MatthiasPopp/replicape/PCB_rev_B4/Replicape_B4.brd

## EAGLE design PCB_rev_B4/Replicape_B4.brd (2019-10-06)

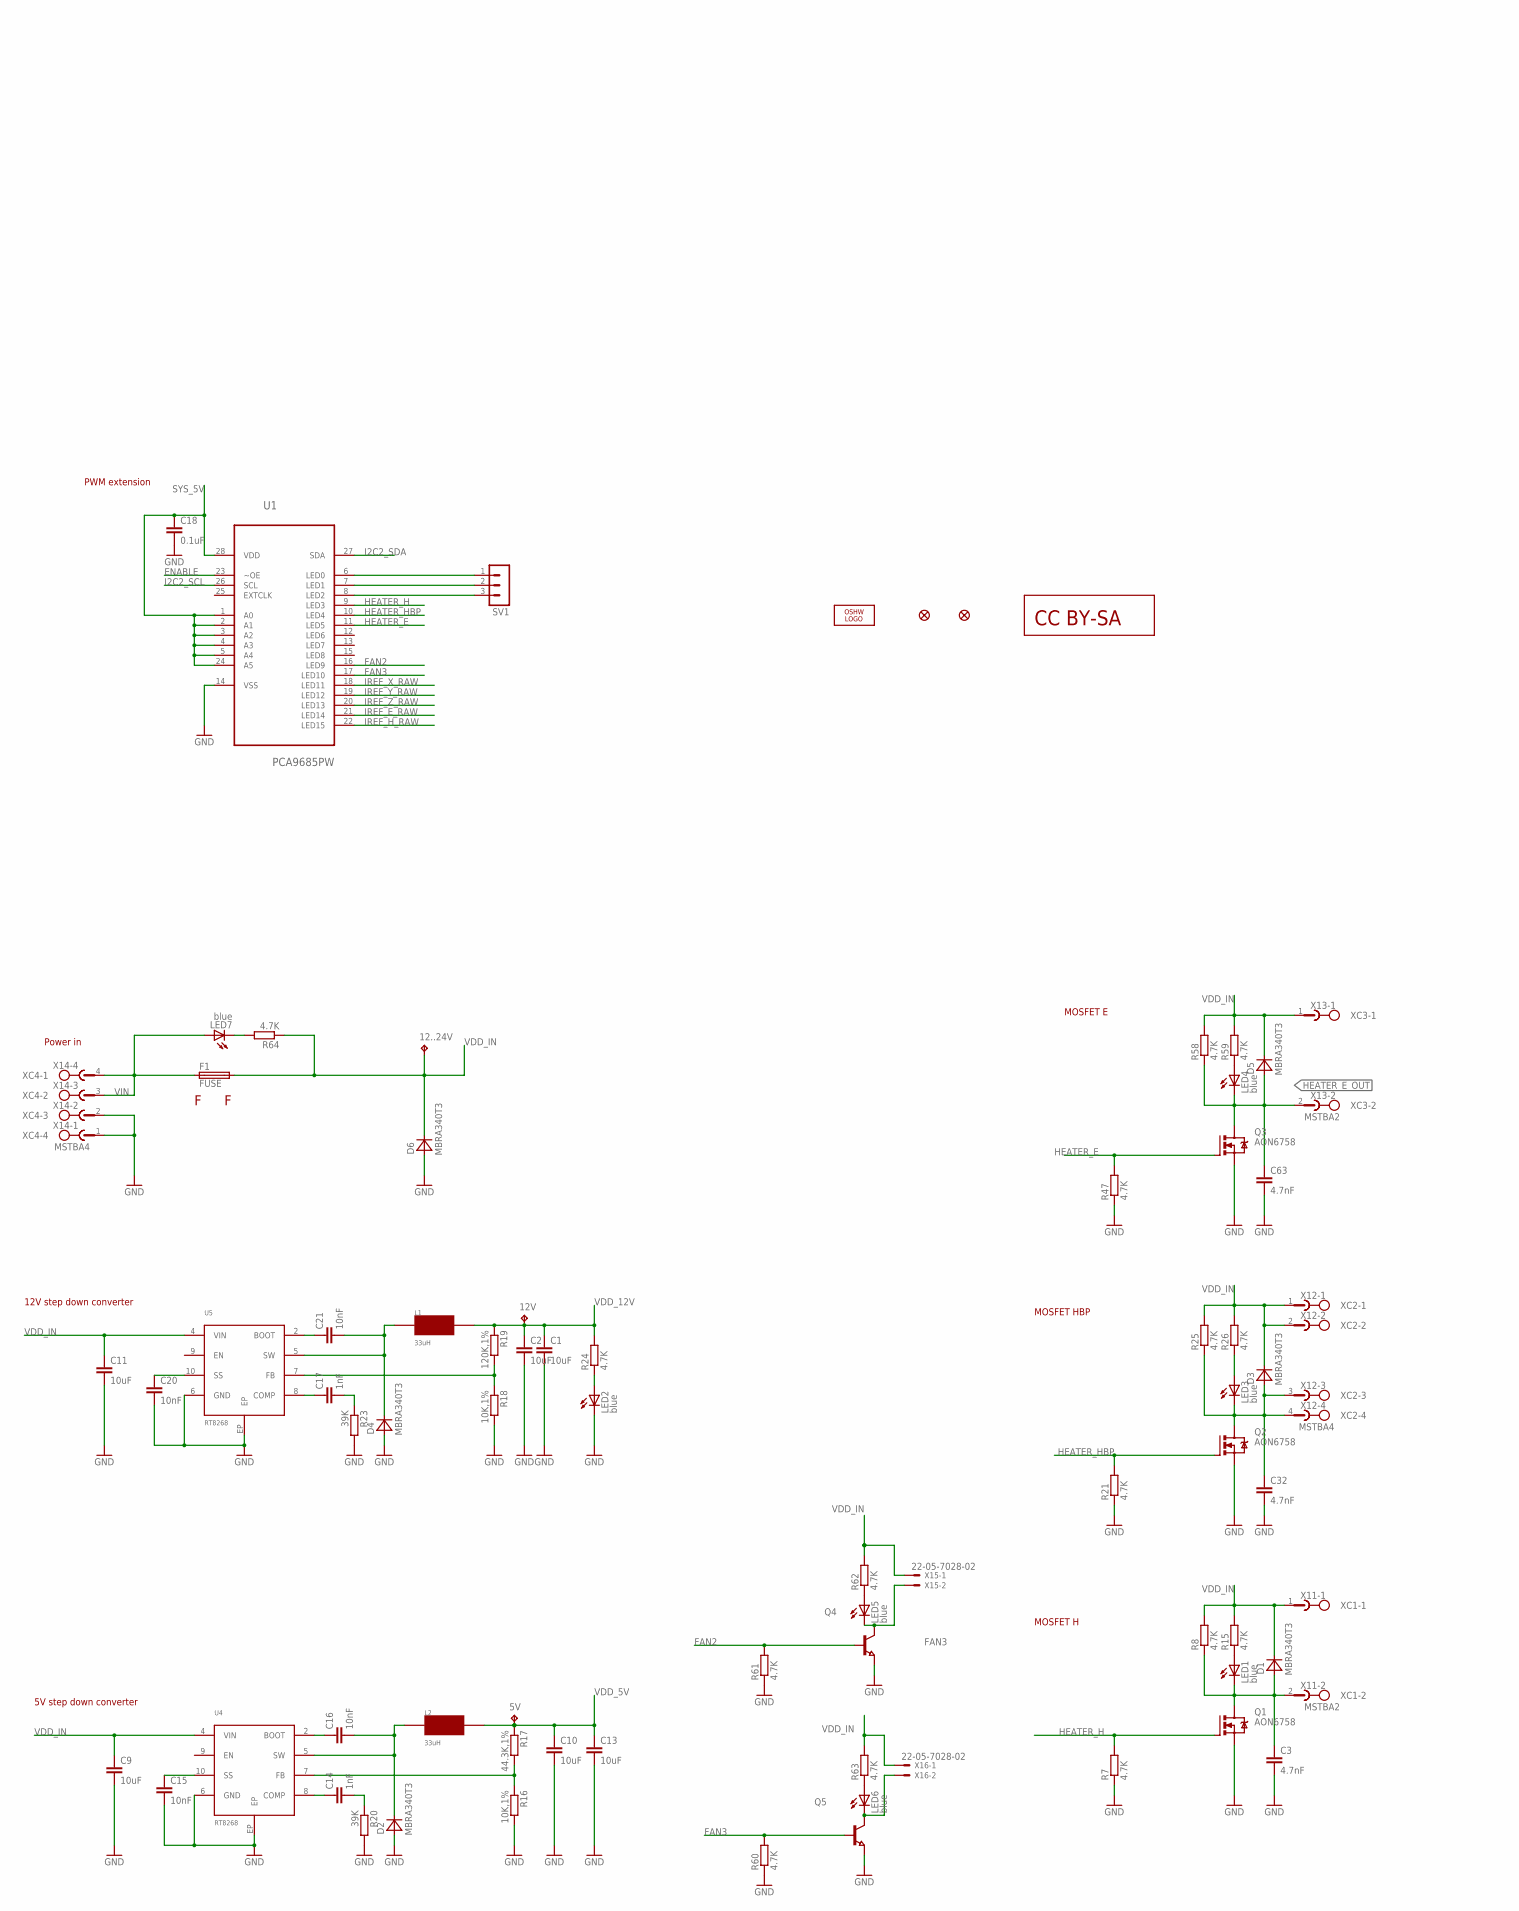
[picture p1: schematic Replicape_B4.sch, sheet 1, part in row 1, column 1]

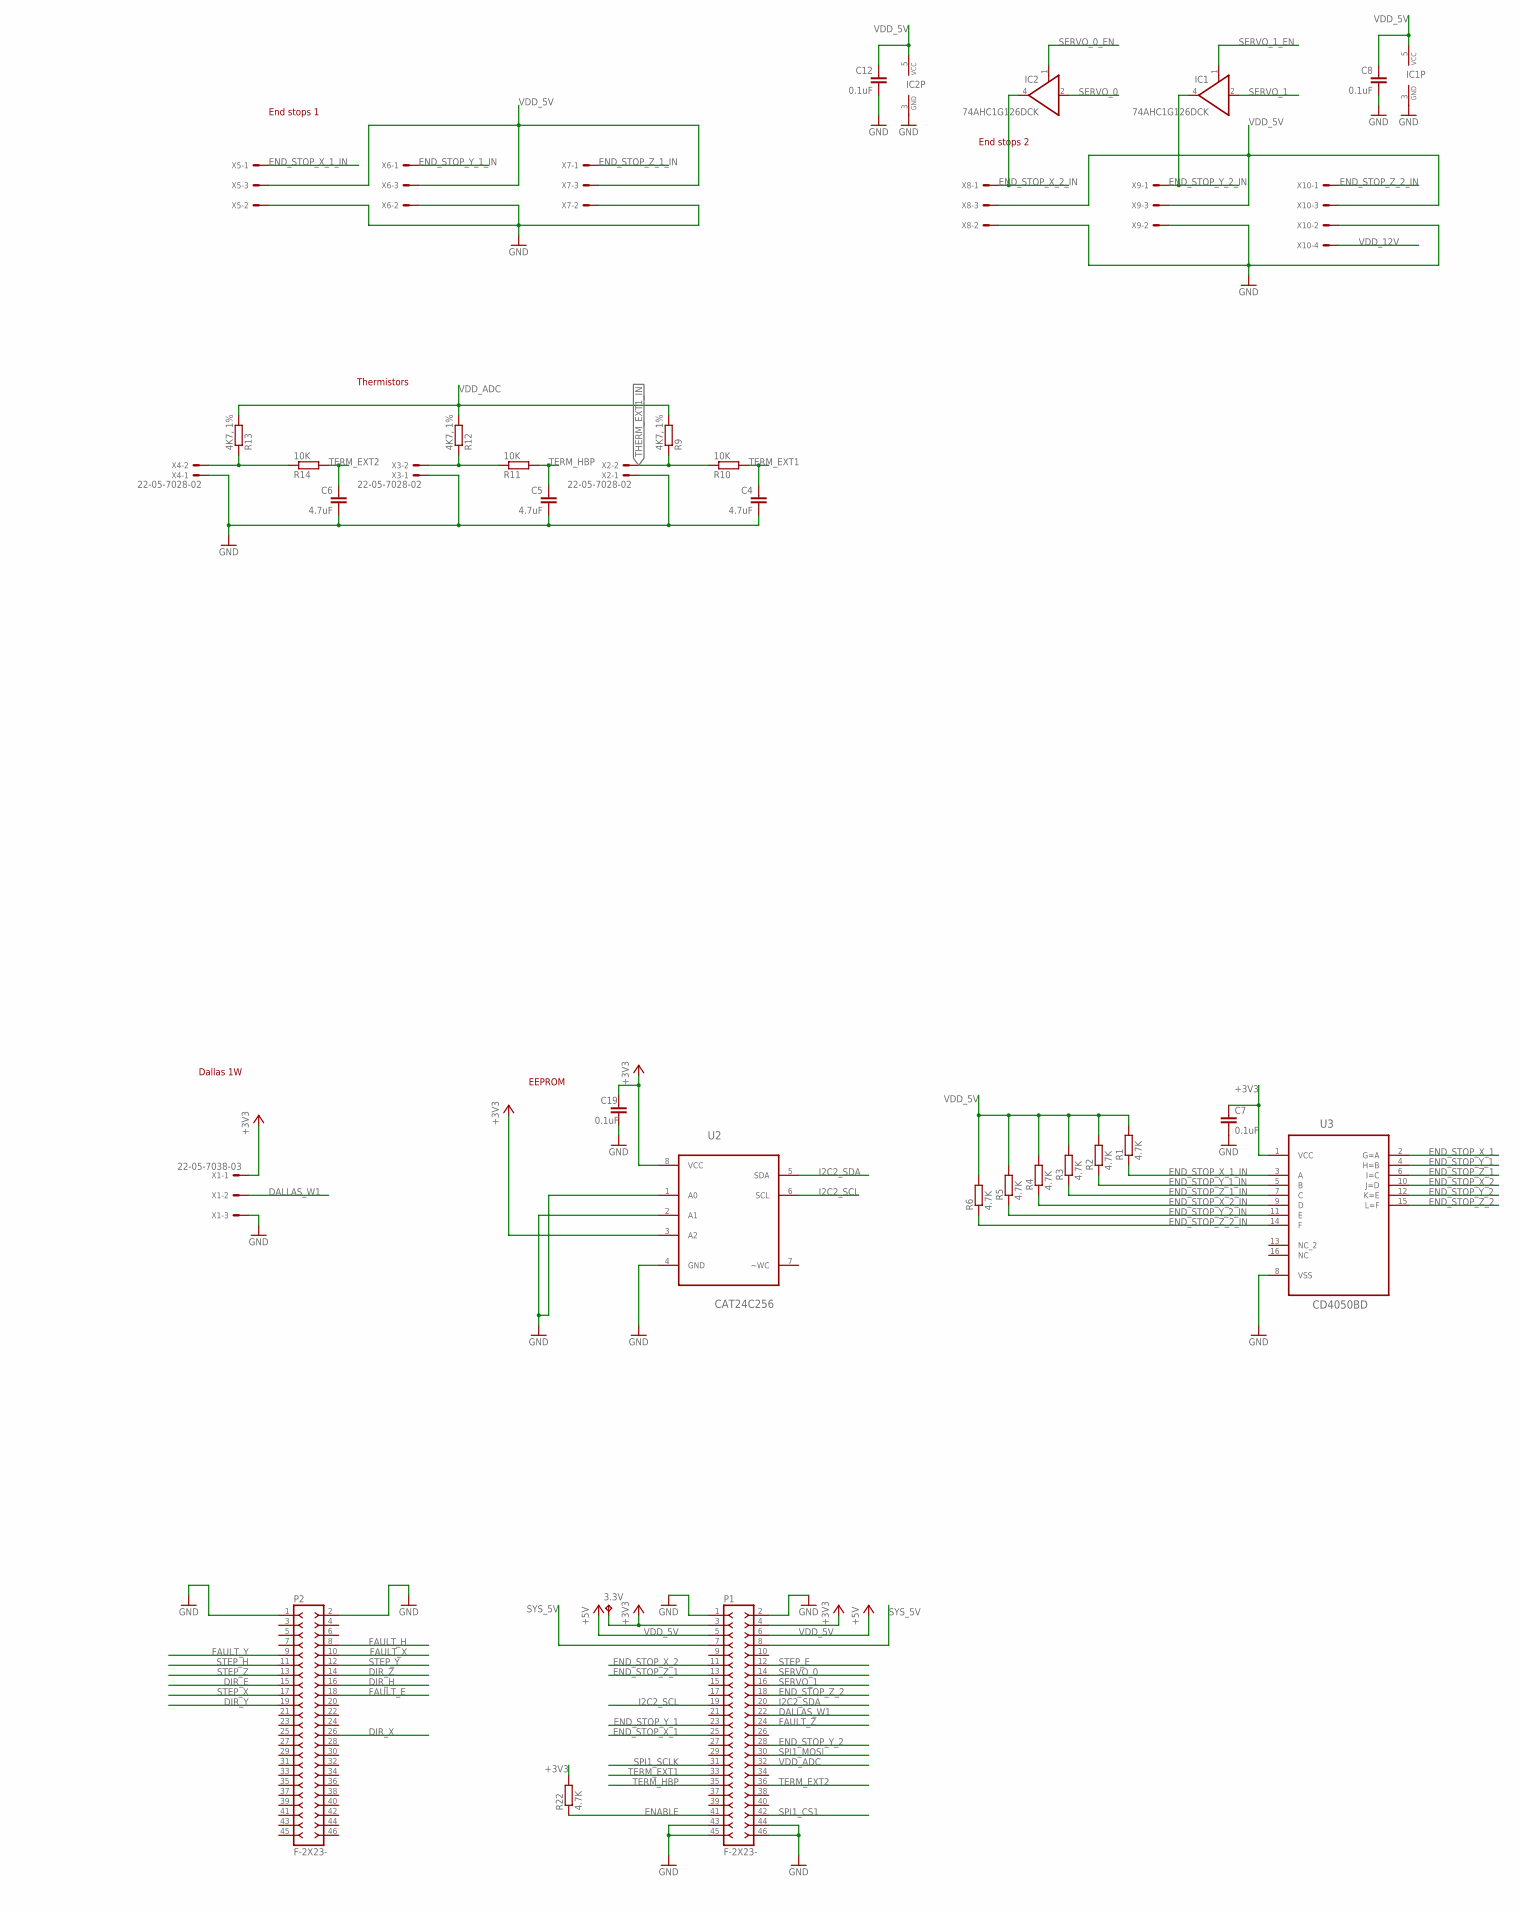
[picture p2: schematic Replicape_B4.sch, sheet 1, part in row 1, column 2]

Parts:
3.3V, 5V, 12..24V, 12V: TPB1,27; B1,27
C1, C2, C9, C10, C11, C13: 10uF; C1206; MPN CL31B106KAHNNNE
C3, C32, C63: 4.7nF; C0402; MPN CL05B472KA5NNNC
C4, C5, C6: 4.7uF; C0402; MPN GRM155R60J475ME47D
C7, C8, C12, C18, C19: 0.1uF; C0402; MPN CL10B104KB8NNND
C14, C17: 1nF; C0402; MPN C1005X7R1H102K050BA
C15, C16, C20, C21: 10nF; C0402; MPN CL05B103KB5NNNC
D1, D2, D3, D4, D5, D6: MBRA340T3; SMA; MPN MBRA340T3G
F1: FUSE; 3557; MPN 0891020.NXS
FH1, FH2: FUSE-HOLDER; MPN 3557
IC1, IC2: 74AHC1G126DCK; SC70-5; MPN M74VHC1GT126DF1G
JP1, JP2: FIDUCIAL1X2.5; FIDUCIAL-1X2.5
L1, L2: 33uH; NR8040T330; MPN NR8040T330M
LED1, LED2, LED3, LED4, LED5, LED6, LED7: blue; CHIP-LED0603; MPN Q65110A7211
LOGO1: OSHW_LOGO_FILLX0200-NT; OSHW_FILLX200_NOTEXT
P1, P2: F-2X23-; DIL-100-2X23; MPN SSHQ-123-D-08-F-LF
Q1, Q2, Q3: AON6758; 8-DFN-EP-(5X6); MPN SIRA34DP-T1-GE3
Q4, Q5: NPN-TRANSISTOR_SOT23; SOT23; MPN AO7400
R1, R2, R3, R4, R5, R6, R7, R8, R15, R21, R22, R24, R25, R26, R47, R58, R59, R60, R61, R62, R63, R64: 4.7K; R0402; MPN RC0402JR-074K7L
R9, R12, R13: 4K7, 1%; R0402; MPN RC0402FR-074K7L
R10, R11, R14: 10K; R0402; MPN RC0402FR-0710KL
R16, R18: 10K,1%; R0402; MPN RC0402FR-0710KL
R17: 44.3K,1%; R0402; MPN RC1005F4422CS
R19: 120K,1%; R0402; MPN RMCF0402FT120K
R20, R23: 39K; R0402; MPN RC1005J393CS
SV1: MA03-1
U1: PCA9685PW; SOP65P640X110-28N; MPN PCA9685PW,112
U2: CAT24C256; SOIC127P600X175-8N; MPN CAT24C256WI-GT3
U3: CD4050BD; SOIC127P600X175-16N; MPN CD4050BDR
U4, U5: RT8268; MSOP10; MPN RT8268GFP
U$1: CC-BY-SA
X1, X5, X6, X7, X8, X9: 22-05-7038-03; 7395-03; MPN 640455-3
X2, X3, X4, X15, X16: 22-05-7028-02; 7395-02; MPN 640455-2
X10: 22-05-7048-04; 7395-04; MPN 640455-4
X11, X13: MSTBA2; MPN 39532-1002
X12, X14: MSTBA4; MPN 39532-1004
XC1, XC3: MSTBV2-CONNECTOR; MSTBA2-CONNECTOR; MPN 39530-0002
XC2, XC4: MSTBA4-CONNECTOR; MPN 39530-0004

Connections:
+3V3: 3.3V.TP, C7.1, C19.1, P1.3, P1.4, R22.2, U2.3 (A2), U2.8 (VCC), U3.1 (VCC), X1.1; also elsewhere on the board
DALLAS_W1: P1.22, X1.2
DIR_E: P2.15; also elsewhere on the board
DIR_H: P2.16; also elsewhere on the board
DIR_X: P2.26; also elsewhere on the board
DIR_Y: P2.19; also elsewhere on the board
DIR_Z: P2.14; also elsewhere on the board
ENABLE: P1.41, R22.1, U1.23 (~OE)
END_STOP_X_1: P1.25, U3.2 (G=A)
END_STOP_X_1_IN: R1.1, U3.3 (A), X5.1
END_STOP_X_2: P1.11, U3.10 (J=D)
END_STOP_X_2_IN: IC2.4 (O), R4.1, U3.9 (D), X8.1
END_STOP_Y_1: P1.23, U3.4 (H=B)
END_STOP_Y_1_IN: R2.1, U3.5 (B), X6.1
END_STOP_Y_2: P1.28, U3.12 (K=E)
END_STOP_Y_2_IN: IC1.4 (O), R5.1, U3.11 (E), X9.1
END_STOP_Z_1: P1.13, U3.6 (I=C)
END_STOP_Z_1_IN: R3.1, U3.7 (C), X7.1
END_STOP_Z_2: P1.18, U3.15 (L=F)
END_STOP_Z_2_IN: R6.1, U3.14 (F), X10.1
FAN2: Q4.1 (B), R61.2, U1.16 (LED9)
FAN3: Q5.1 (B), R60.2, U1.17 (LED10)
FAULT_E: P2.18; also elsewhere on the board
FAULT_H: P2.8; also elsewhere on the board
FAULT_X: P2.10; also elsewhere on the board
FAULT_Y: P2.9; also elsewhere on the board
FAULT_Z: P1.24; also elsewhere on the board
GND: C1.2, C2.2, C3.2, C4.2, C5.2, C6.2, C7.2, C8.2, C9.2, C10.2, C11.2, C12.2, C13.2, C15.2, C18.2, C19.2, C20.2, C32.2, C63.2, D2.A, D4.A, D6.A, IC1.3 (GND), IC2.3 (GND), LED2.C, P1.1, P1.2, P1.43, P1.44, P1.45, P1.46, P2.1, P2.2, Q1.1 (S), Q1.2 (S), Q1.3 (S), Q2.1 (S), Q2.2 (S), Q2.3 (S), Q3.1 (S), Q3.2 (S), Q3.3 (S), Q4.2 (E), Q5.2 (E), R7.1, R16.2, R18.2, R20.2, R21.1, R23.2, R47.1, R60.1, R61.1, U1.14 (VSS), U2.1 (A0), U2.2 (A1), U2.4 (GND), U3.8 (VSS), U4.6 (GND), U4.EP, U5.6 (GND), U5.EP, X1.3, X2.1, X3.1, X4.1, X5.2, X6.2, X7.2, X8.2, X9.2, X10.2, X14.1, X14.2; also elsewhere on the board
HEATER_E: Q3.4 (G), R47.2, U1.11 (LED5)
HEATER_E_OUT: C63.1, D5.A, LED4.C, Q3.5 (D), Q3.6 (D), Q3.7 (D), Q3.8 (D), Q3.TH (D), R58.1, X13.2
HEATER_H: Q1.4 (G), R7.2, U1.9 (LED3)
HEATER_HBP: Q2.4 (G), R21.2, U1.10 (LED4)
I2C2_SCL: P1.19, U1.26 (SCL), U2.6 (SCL)
I2C2_SDA: P1.20, U1.27 (SDA), U2.5 (SDA)
IREF_E_RAW: U1.21 (LED14); also elsewhere on the board
IREF_H_RAW: U1.22 (LED15); also elsewhere on the board
IREF_X_RAW: U1.18 (LED11); also elsewhere on the board
IREF_Y_RAW: U1.19 (LED12); also elsewhere on the board
IREF_Z_RAW: U1.20 (LED13); also elsewhere on the board
unnamed: SV1.1, U1.6 (LED0)
unnamed: LED7.C, R64.2
unnamed: R16.1, R17.2, U4.7 (FB)
unnamed: C16.2, D2.C, L2.P$2, U4.5 (SW)
unnamed: C15.1, U4.10 (SS)
unnamed: C3.1, D1.A, LED1.C, Q1.5 (D), Q1.6 (D), Q1.7 (D), Q1.8 (D), Q1.TH (D), R8.1, X11.2
unnamed: C16.1, U4.2 (BOOT)
unnamed: C14.1, U4.8 (COMP)
unnamed: LED2.A, R24.1
unnamed: C14.2, R20.1
unnamed: LED6.C, Q5.3 (C), X16.2
unnamed: LED5.C, Q4.3 (C), X15.2
unnamed: LED5.A, R62.1
unnamed: LED6.A, R63.1
unnamed: SV1.3, U1.8 (LED2)
unnamed: SV1.2, U1.7 (LED1)
unnamed: LED4.A, R59.1
unnamed: LED1.A, R15.1
unnamed: LED3.A, R26.1
unnamed: R18.1, R19.2, U5.7 (FB)
unnamed: C21.2, D4.C, L1.P$2, U5.5 (SW)
unnamed: R13.1, R14.1, X4.2
unnamed: R11.1, R12.1, X3.2
unnamed: C32.1, D3.A, LED3.C, Q2.5 (D), Q2.6 (D), Q2.7 (D), Q2.8 (D), Q2.TH (D), R25.1, X12.3, X12.4
unnamed: C20.1, U5.10 (SS)
unnamed: C17.1, U5.8 (COMP)
unnamed: C21.1, U5.2 (BOOT)
unnamed: C17.2, R23.1
SERVO_0: IC2.2 (I), P1.14
SERVO_0_EN: IC2.1 (OE); also elsewhere on the board
SERVO_1: IC1.2 (I), P1.16
SERVO_1_EN: IC1.1 (OE); also elsewhere on the board
SPI1_CS1: P1.42; also elsewhere on the board
SPI1_MOSI: P1.30; also elsewhere on the board
SPI1_SCLK: P1.31; also elsewhere on the board
STEP_E: P1.12; also elsewhere on the board
STEP_H: P2.11; also elsewhere on the board
STEP_X: P2.17; also elsewhere on the board
STEP_Y: P2.12; also elsewhere on the board
STEP_Z: P2.13; also elsewhere on the board
SYS_5V: C18.1, P1.7, P1.8, U1.1 (A0), U1.2 (A1), U1.3 (A2), U1.4 (A3), U1.5 (A4), U1.24 (A5), U1.28 (VDD)
TERM_EXT1: C4.1, P1.33, R10.2
TERM_EXT2: C6.1, P1.36, R14.2
TERM_HBP: C5.1, P1.35, R11.2
THERM_EXT1_IN: R9.1, R10.1, X2.2
VDD_5V: 5V.TP, C8.1, C10.1, C12.1, C13.1, IC1.5 (VCC), IC2.5 (VCC), L2.P$1, P1.5, P1.6, R1.2, R2.2, R3.2, R4.2, R5.2, R6.2, R17.1, X5.3, X6.3, X7.3, X8.3, X9.3, X10.3
VDD_12V: 12V.TP, C1.1, C2.1, L1.P$1, R19.1, R24.2, X10.4
VDD_ADC: P1.32, R9.2, R12.2, R13.2
VDD_IN: 12..24V.TP, C9.1, C11.1, D1.C, D3.C, D5.C, D6.C, F1.P$3 (2), F1.P$4 (2), R8.2, R15.2, R25.2, R26.2, R58.2, R59.2, R62.2, R63.2, R64.1, U4.4 (VIN), U5.4 (VIN), X11.1, X12.1, X12.2, X13.1, X15.1, X16.1; also elsewhere on the board
VIN: F1.P$1 (1), F1.P$2 (1), LED7.A, X14.3, X14.4

Notes on the sheet:
PWM extension
Power in
5V step down converter
12V step down converter
MOSFET E
MOSFET HBP
MOSFET H
End stops 2
Thermistors
End stops 1
EEPROM
Dallas 1W

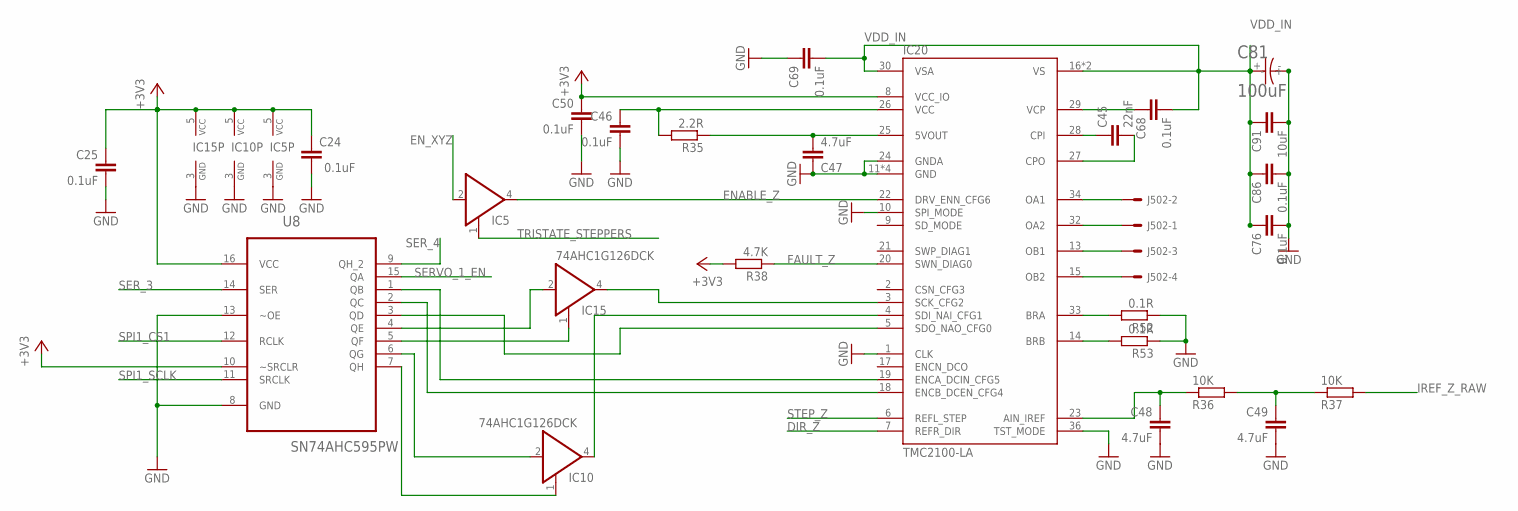
[picture p3: schematic Replicape_B4.sch, sheet 2]

Parts:
C24, C25, C46, C50, C68, C69, C76, C86: 0.1uF; C0402; MPN CL10B104KB8NNND
C45: 22nF; C0402; MPN C1005X7R1E223K050BB
C47, C48, C49: 4.7uF; C0402; MPN GRM155R60J475ME47D
C81: 100uF; RHS1V10MCN1GS; MPN RHS1V101MCN1GS
C91: 10uF; C0805; MPN C2012X5R1V106M085AC
IC5, IC10, IC15: 74AHC1G126DCK; SC70-5; MPN M74VHC1GT126DF1G
IC20: TMC2100-LA; QFN36-PAD; MPN TMC2100-LA-T
J502: 22-05-7048-04; 7395-04; MPN 640455-4
R35: 2.2R; R0402; MPN RC1005J2R2CS
R36, R37: 10K; R0402; MPN RC0402FR-0710KL
R38: 4.7K; R0402; MPN RC0402JR-074K7L
R52, R53: 0.1R; R0805; MPN RL1220S-R10-F
U8: SN74AHC595PW; SOP65P640X120-16N; MPN MC74HC595ADTR2G

Connections:
+3V3: C24.1, C25.1, C50.1, IC5.5 (VCC), IC10.5 (VCC), IC15.5 (VCC), IC20.8 (VCC_IO), R38.2, U8.10 (~SRCLR), U8.16 (VCC); also elsewhere on the board
DIR_Z: IC20.7 (REFR_DIR); also elsewhere on the board
ENABLE_Z: IC5.4 (O), IC20.22 (DRV_ENN_CFG6)
EN_XYZ: IC5.2 (I); also elsewhere on the board
FAULT_Z: IC20.20 (SWN_DIAG0), R38.1; also elsewhere on the board
GND: C24.2, C25.2, C46.2, C47.1, C48.2, C49.2, C50.2, C69.1, C76.2, C81.-, C86.2, C91.2, IC5.3 (GND), IC10.3 (GND), IC15.3 (GND), IC20.1 (CLK), IC20.10 (SPI_MODE), IC20.11 (GND), IC20.12 (GND), IC20.24 (GNDA), IC20.35 (GND), IC20.36 (TST_MODE), IC20.TP (GND), R52.1, R53.1, U8.8 (GND), U8.13 (~OE); also elsewhere on the board
IREF_Z6: C49.1, R36.2, R37.1
IREF_Z_RAW: R37.2; also elsewhere on the board
unnamed: C45.2, IC20.27 (CPO)
unnamed: IC20.14 (BRB), R53.2
unnamed: IC20.33 (BRA), R52.2
unnamed: C48.1, IC20.23 (AIN_IREF), R36.1
unnamed: C45.1, IC20.28 (CPI)
unnamed: IC15.4 (O), IC20.3 (SCK_CFG2)
unnamed: C47.2, IC20.25 (5VOUT), R35.1
unnamed: C68.1, IC20.29 (VCP)
unnamed: IC10.4 (O), IC20.4 (SDI_NAI_CFG1)
unnamed: IC20.5 (SDO_NAO_CFG0), U8.3 (QD)
unnamed: IC20.18 (ENCB_DCEN_CFG4), U8.2 (QC)
unnamed: IC20.19 (ENCA_DCIN_CFG5), U8.1 (QB)
unnamed: IC10.1 (OE), U8.7 (QH)
unnamed: IC10.2 (I), U8.6 (QG)
unnamed: IC15.2 (I), U8.4 (QE)
unnamed: IC15.1 (OE), U8.5 (QF)
unnamed: C46.1, IC20.26 (VCC), R35.2
unnamed: IC20.15 (OB2), J502.4
unnamed: IC20.34 (OA1), J502.2
unnamed: IC20.32 (OA2), J502.1
unnamed: IC20.13 (OB1), J502.3
SERVO_1_EN: U8.15 (QA); also elsewhere on the board
SER_3: U8.14 (SER); also elsewhere on the board
SER_4: U8.9 (QH_2); also elsewhere on the board
SPI1_CS1: U8.12 (RCLK); also elsewhere on the board
SPI1_SCLK: U8.11 (SRCLK); also elsewhere on the board
STEP_Z: IC20.6 (REFL_STEP); also elsewhere on the board
TRISTATE_STEPPERS: IC5.1 (OE); also elsewhere on the board
VDD_IN: C68.2, C69.2, C76.1, C81.+, C86.1, C91.1, IC20.16 (VS), IC20.30 (VSA), IC20.31 (VS); also elsewhere on the board

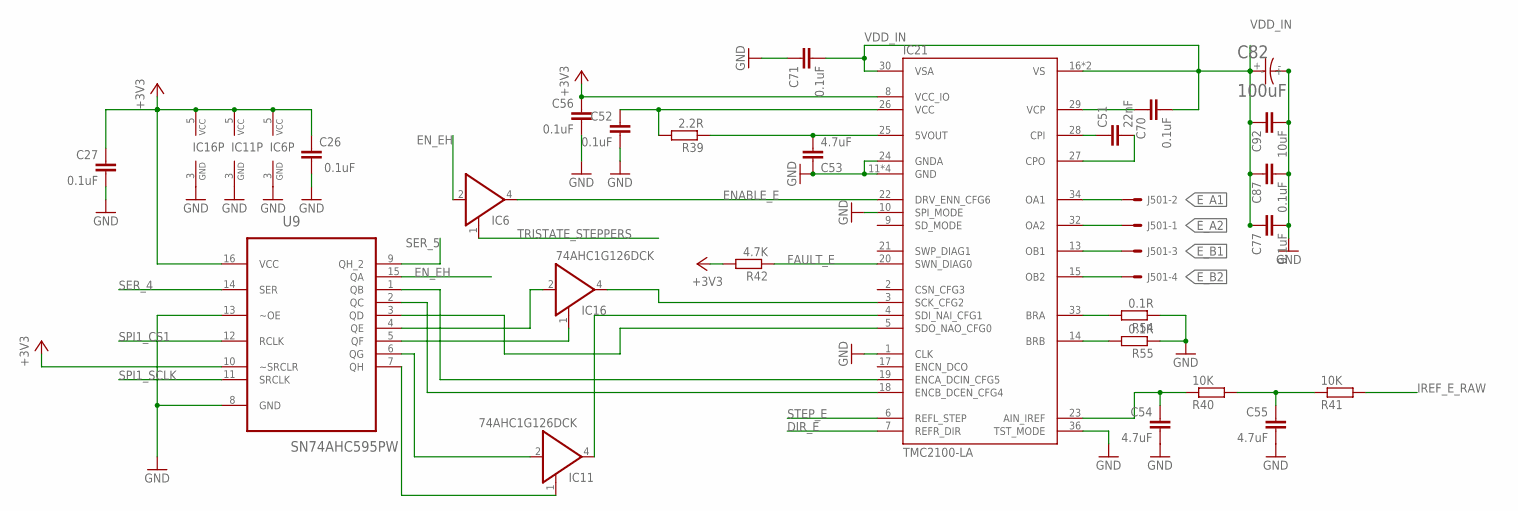
[picture p4: schematic Replicape_B4.sch, sheet 3]

Parts:
C26, C27, C52, C56, C70, C71, C77, C87: 0.1uF; C0402; MPN CL10B104KB8NNND
C51: 22nF; C0402; MPN C1005X7R1E223K050BB
C53, C54, C55: 4.7uF; C0402; MPN GRM155R60J475ME47D
C82: 100uF; RHS1V10MCN1GS; MPN RHS1V101MCN1GS
C92: 10uF; C0805; MPN C2012X5R1V106M085AC
IC6, IC11, IC16: 74AHC1G126DCK; SC70-5; MPN M74VHC1GT126DF1G
IC21: TMC2100-LA; QFN36-PAD; MPN TMC2100-LA-T
J501: 22-05-7048-04; 7395-04; MPN 640455-4
R39: 2.2R; R0402; MPN RC1005J2R2CS
R40, R41: 10K; R0402; MPN RC0402FR-0710KL
R42: 4.7K; R0402; MPN RC0402JR-074K7L
R54, R55: 0.1R; R0805; MPN RL1220S-R10-F
U9: SN74AHC595PW; SOP65P640X120-16N; MPN MC74HC595ADTR2G

Connections:
+3V3: C26.1, C27.1, C56.1, IC6.5 (VCC), IC11.5 (VCC), IC16.5 (VCC), IC21.8 (VCC_IO), R42.2, U9.10 (~SRCLR), U9.16 (VCC); also elsewhere on the board
DIR_E: IC21.7 (REFR_DIR); also elsewhere on the board
ENABLE_E: IC6.4 (O), IC21.22 (DRV_ENN_CFG6)
EN_EH: IC6.2 (I), U9.15 (QA); also elsewhere on the board
E_A1: IC21.34 (OA1), J501.2
E_A2: IC21.32 (OA2), J501.1
E_B1: IC21.13 (OB1), J501.3
E_B2: IC21.15 (OB2), J501.4
FAULT_E: IC21.20 (SWN_DIAG0), R42.1; also elsewhere on the board
GND: C26.2, C27.2, C52.2, C53.1, C54.2, C55.2, C56.2, C71.1, C77.2, C82.-, C87.2, C92.2, IC6.3 (GND), IC11.3 (GND), IC16.3 (GND), IC21.1 (CLK), IC21.10 (SPI_MODE), IC21.11 (GND), IC21.12 (GND), IC21.24 (GNDA), IC21.35 (GND), IC21.36 (TST_MODE), IC21.TP (GND), R54.1, R55.1, U9.8 (GND), U9.13 (~OE); also elsewhere on the board
IREF_E_RAW: R41.2; also elsewhere on the board
IREF_Z7: C55.1, R40.2, R41.1
unnamed: C51.2, IC21.27 (CPO)
unnamed: IC21.14 (BRB), R55.2
unnamed: IC21.33 (BRA), R54.2
unnamed: C54.1, IC21.23 (AIN_IREF), R40.1
unnamed: C51.1, IC21.28 (CPI)
unnamed: IC16.4 (O), IC21.3 (SCK_CFG2)
unnamed: C53.2, IC21.25 (5VOUT), R39.1
unnamed: C70.1, IC21.29 (VCP)
unnamed: IC11.4 (O), IC21.4 (SDI_NAI_CFG1)
unnamed: IC21.5 (SDO_NAO_CFG0), U9.3 (QD)
unnamed: IC21.18 (ENCB_DCEN_CFG4), U9.2 (QC)
unnamed: IC21.19 (ENCA_DCIN_CFG5), U9.1 (QB)
unnamed: IC11.1 (OE), U9.7 (QH)
unnamed: IC11.2 (I), U9.6 (QG)
unnamed: IC16.2 (I), U9.4 (QE)
unnamed: IC16.1 (OE), U9.5 (QF)
unnamed: C52.1, IC21.26 (VCC), R39.2
SER_4: U9.14 (SER); also elsewhere on the board
SER_5: U9.9 (QH_2); also elsewhere on the board
SPI1_CS1: U9.12 (RCLK); also elsewhere on the board
SPI1_SCLK: U9.11 (SRCLK); also elsewhere on the board
STEP_E: IC21.6 (REFL_STEP); also elsewhere on the board
TRISTATE_STEPPERS: IC6.1 (OE); also elsewhere on the board
VDD_IN: C70.2, C71.2, C77.1, C82.+, C87.1, C92.1, IC21.16 (VS), IC21.30 (VSA), IC21.31 (VS); also elsewhere on the board

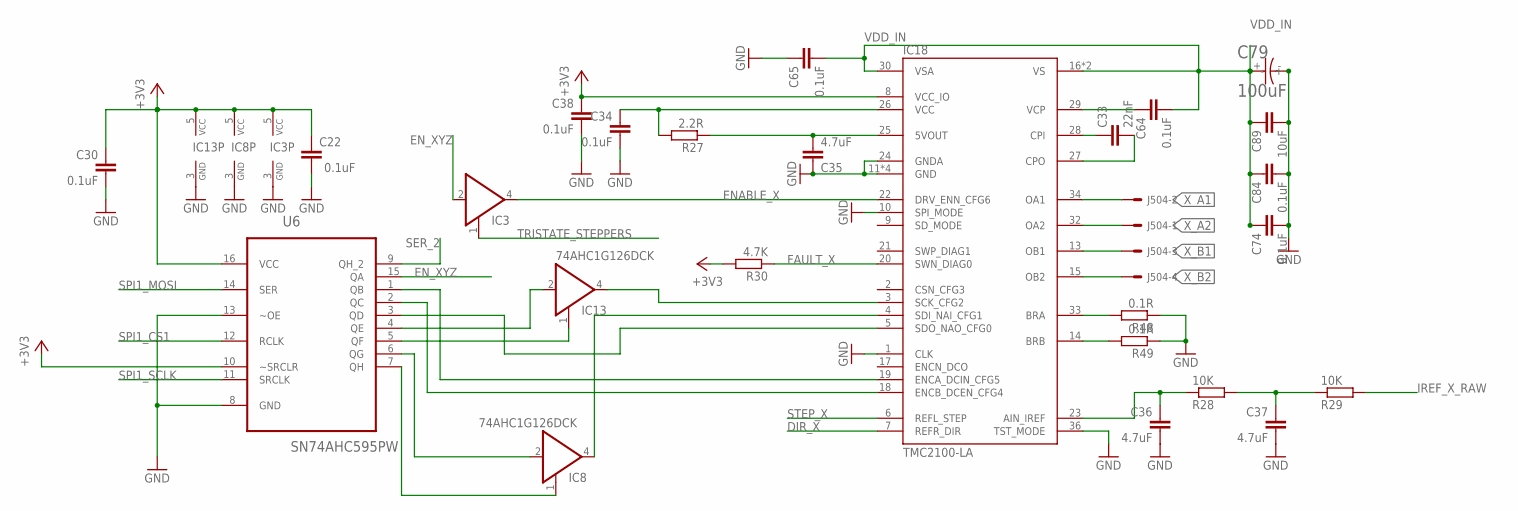
[picture p5: schematic Replicape_B4.sch, sheet 4]

Parts:
C22, C30, C34, C38, C64, C65, C74, C84: 0.1uF; C0402; MPN CL10B104KB8NNND
C33: 22nF; C0402; MPN C1005X7R1E223K050BB
C35, C36, C37: 4.7uF; C0402; MPN GRM155R60J475ME47D
C79: 100uF; RHS1V10MCN1GS; MPN RHS1V101MCN1GS
C89: 10uF; C0805; MPN C2012X5R1V106M085AC
IC3, IC8, IC13: 74AHC1G126DCK; SC70-5; MPN M74VHC1GT126DF1G
IC18: TMC2100-LA; QFN36-PAD; MPN TMC2100-LA-T
J504: 22-05-7048-04; 7395-04; MPN 640455-4
R27: 2.2R; R0402; MPN RC1005J2R2CS
R28, R29: 10K; R0402; MPN RC0402FR-0710KL
R30: 4.7K; R0402; MPN RC0402JR-074K7L
R48, R49: 0.1R; R0805; MPN RL1220S-R10-F
U6: SN74AHC595PW; SOP65P640X120-16N; MPN MC74HC595ADTR2G

Connections:
+3V3: C22.1, C30.1, C38.1, IC3.5 (VCC), IC8.5 (VCC), IC13.5 (VCC), IC18.8 (VCC_IO), R30.2, U6.10 (~SRCLR), U6.16 (VCC); also elsewhere on the board
DIR_X: IC18.7 (REFR_DIR); also elsewhere on the board
ENABLE_X: IC3.4 (O), IC18.22 (DRV_ENN_CFG6)
EN_XYZ: IC3.2 (I), U6.15 (QA); also elsewhere on the board
FAULT_X: IC18.20 (SWN_DIAG0), R30.1; also elsewhere on the board
GND: C22.2, C30.2, C34.2, C35.1, C36.2, C37.2, C38.2, C65.1, C74.2, C79.-, C84.2, C89.2, IC3.3 (GND), IC8.3 (GND), IC13.3 (GND), IC18.1 (CLK), IC18.10 (SPI_MODE), IC18.11 (GND), IC18.12 (GND), IC18.24 (GNDA), IC18.35 (GND), IC18.36 (TST_MODE), IC18.TP (GND), R48.1, R49.1, U6.8 (GND), U6.13 (~OE); also elsewhere on the board
IREF_X_RAW: R29.2; also elsewhere on the board
IREF_Z8: C37.1, R28.2, R29.1
unnamed: C33.2, IC18.27 (CPO)
unnamed: IC18.14 (BRB), R49.2
unnamed: IC18.33 (BRA), R48.2
unnamed: C36.1, IC18.23 (AIN_IREF), R28.1
unnamed: C33.1, IC18.28 (CPI)
unnamed: IC13.4 (O), IC18.3 (SCK_CFG2)
unnamed: C35.2, IC18.25 (5VOUT), R27.1
unnamed: C64.1, IC18.29 (VCP)
unnamed: IC8.4 (O), IC18.4 (SDI_NAI_CFG1)
unnamed: IC18.5 (SDO_NAO_CFG0), U6.3 (QD)
unnamed: IC18.18 (ENCB_DCEN_CFG4), U6.2 (QC)
unnamed: IC18.19 (ENCA_DCIN_CFG5), U6.1 (QB)
unnamed: IC8.1 (OE), U6.7 (QH)
unnamed: IC8.2 (I), U6.6 (QG)
unnamed: IC13.2 (I), U6.4 (QE)
unnamed: IC13.1 (OE), U6.5 (QF)
unnamed: C34.1, IC18.26 (VCC), R27.2
SER_2: U6.9 (QH_2); also elsewhere on the board
SPI1_CS1: U6.12 (RCLK); also elsewhere on the board
SPI1_MOSI: U6.14 (SER); also elsewhere on the board
SPI1_SCLK: U6.11 (SRCLK); also elsewhere on the board
STEP_X: IC18.6 (REFL_STEP); also elsewhere on the board
TRISTATE_STEPPERS: IC3.1 (OE); also elsewhere on the board
VDD_IN: C64.2, C65.2, C74.1, C79.+, C84.1, C89.1, IC18.16 (VS), IC18.30 (VSA), IC18.31 (VS); also elsewhere on the board
X_A1: IC18.34 (OA1), J504.2
X_A2: IC18.32 (OA2), J504.1
X_B1: IC18.13 (OB1), J504.3
X_B2: IC18.15 (OB2), J504.4

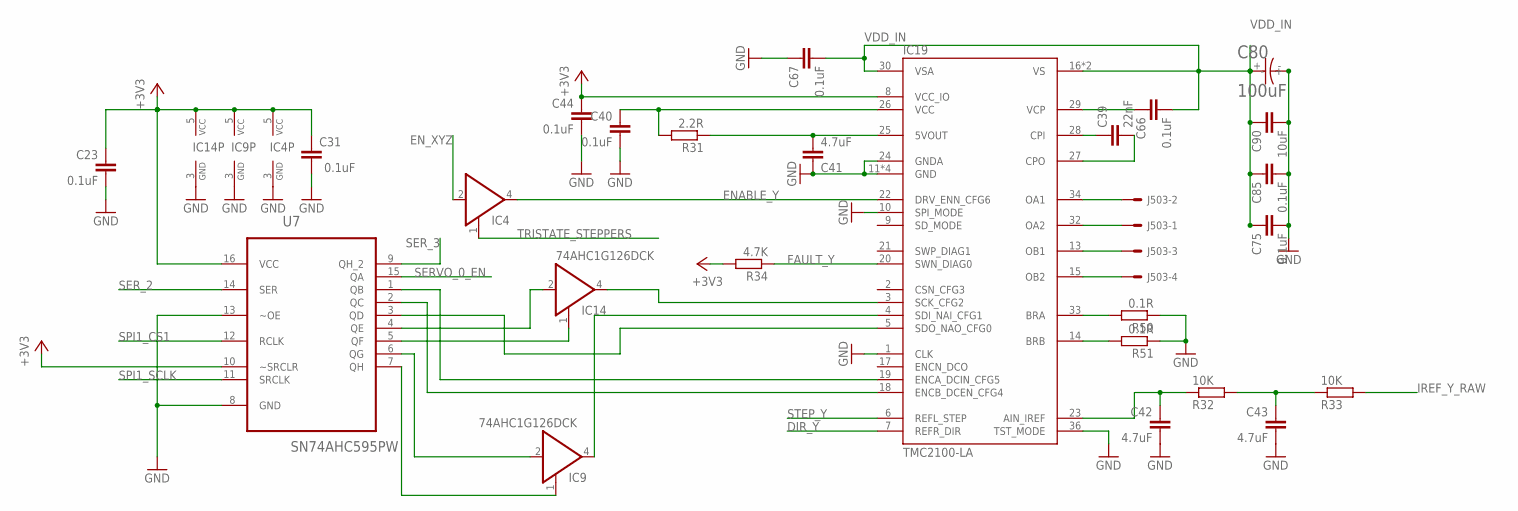
[picture p6: schematic Replicape_B4.sch, sheet 5]

Parts:
C23, C31, C40, C44, C66, C67, C75, C85: 0.1uF; C0402; MPN CL10B104KB8NNND
C39: 22nF; C0402; MPN C1005X7R1E223K050BB
C41, C42, C43: 4.7uF; C0402; MPN GRM155R60J475ME47D
C80: 100uF; RHS1V10MCN1GS; MPN RHS1V101MCN1GS
C90: 10uF; C0805; MPN C2012X5R1V106M085AC
IC4, IC9, IC14: 74AHC1G126DCK; SC70-5; MPN M74VHC1GT126DF1G
IC19: TMC2100-LA; QFN36-PAD; MPN TMC2100-LA-T
J503: 22-05-7048-04; 7395-04; MPN 640455-4
R31: 2.2R; R0402; MPN RC1005J2R2CS
R32, R33: 10K; R0402; MPN RC0402FR-0710KL
R34: 4.7K; R0402; MPN RC0402JR-074K7L
R50, R51: 0.1R; R0805; MPN RL1220S-R10-F
U7: SN74AHC595PW; SOP65P640X120-16N; MPN MC74HC595ADTR2G

Connections:
+3V3: C23.1, C31.1, C44.1, IC4.5 (VCC), IC9.5 (VCC), IC14.5 (VCC), IC19.8 (VCC_IO), R34.2, U7.10 (~SRCLR), U7.16 (VCC); also elsewhere on the board
DIR_Y: IC19.7 (REFR_DIR); also elsewhere on the board
ENABLE_Y: IC4.4 (O), IC19.22 (DRV_ENN_CFG6)
EN_XYZ: IC4.2 (I); also elsewhere on the board
FAULT_Y: IC19.20 (SWN_DIAG0), R34.1; also elsewhere on the board
GND: C23.2, C31.2, C40.2, C41.1, C42.2, C43.2, C44.2, C67.1, C75.2, C80.-, C85.2, C90.2, IC4.3 (GND), IC9.3 (GND), IC14.3 (GND), IC19.1 (CLK), IC19.10 (SPI_MODE), IC19.11 (GND), IC19.12 (GND), IC19.24 (GNDA), IC19.35 (GND), IC19.36 (TST_MODE), IC19.TP (GND), R50.1, R51.1, U7.8 (GND), U7.13 (~OE); also elsewhere on the board
IREF_Y_RAW: R33.2; also elsewhere on the board
IREF_Z9: C43.1, R32.2, R33.1
unnamed: C39.2, IC19.27 (CPO)
unnamed: IC19.14 (BRB), R51.2
unnamed: IC19.33 (BRA), R50.2
unnamed: C42.1, IC19.23 (AIN_IREF), R32.1
unnamed: C39.1, IC19.28 (CPI)
unnamed: IC14.4 (O), IC19.3 (SCK_CFG2)
unnamed: IC19.15 (OB2), J503.4
unnamed: IC19.34 (OA1), J503.2
unnamed: C41.2, IC19.25 (5VOUT), R31.1
unnamed: C66.1, IC19.29 (VCP)
unnamed: IC9.4 (O), IC19.4 (SDI_NAI_CFG1)
unnamed: IC19.5 (SDO_NAO_CFG0), U7.3 (QD)
unnamed: IC19.18 (ENCB_DCEN_CFG4), U7.2 (QC)
unnamed: IC19.19 (ENCA_DCIN_CFG5), U7.1 (QB)
unnamed: IC9.1 (OE), U7.7 (QH)
unnamed: IC9.2 (I), U7.6 (QG)
unnamed: IC14.2 (I), U7.4 (QE)
unnamed: IC14.1 (OE), U7.5 (QF)
unnamed: C40.1, IC19.26 (VCC), R31.2
unnamed: IC19.32 (OA2), J503.1
unnamed: IC19.13 (OB1), J503.3
SERVO_0_EN: U7.15 (QA); also elsewhere on the board
SER_2: U7.14 (SER); also elsewhere on the board
SER_3: U7.9 (QH_2); also elsewhere on the board
SPI1_CS1: U7.12 (RCLK); also elsewhere on the board
SPI1_SCLK: U7.11 (SRCLK); also elsewhere on the board
STEP_Y: IC19.6 (REFL_STEP); also elsewhere on the board
TRISTATE_STEPPERS: IC4.1 (OE); also elsewhere on the board
VDD_IN: C66.2, C67.2, C75.1, C80.+, C85.1, C90.1, IC19.16 (VS), IC19.30 (VSA), IC19.31 (VS); also elsewhere on the board

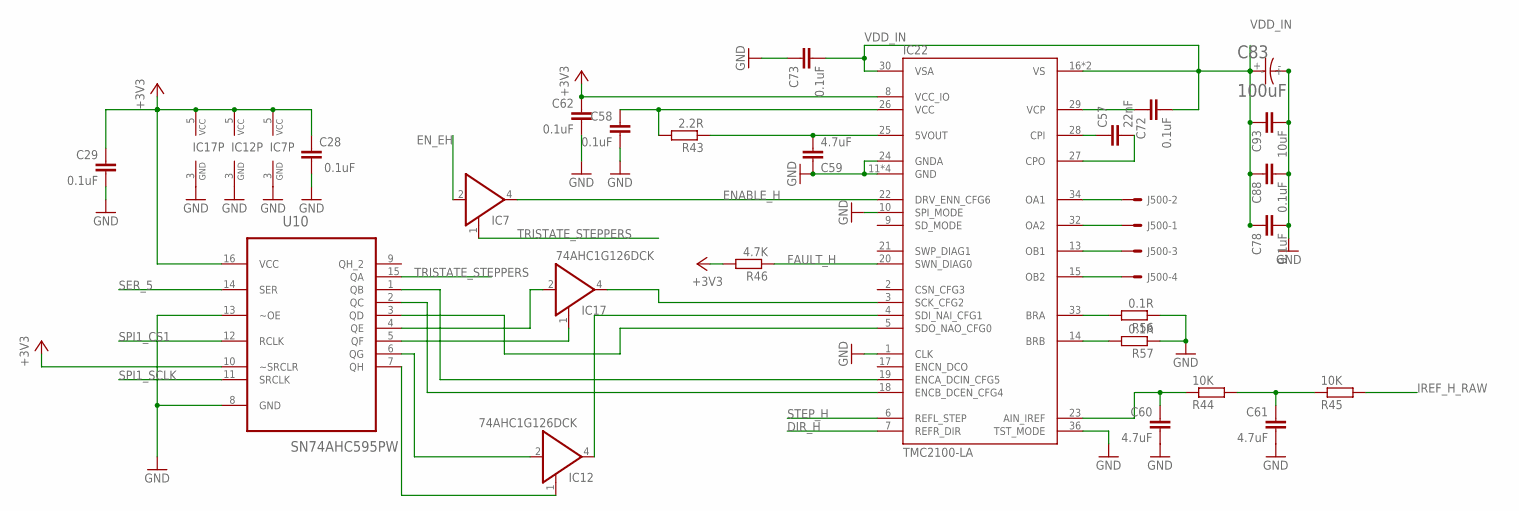
[picture p7: schematic Replicape_B4.sch, sheet 6]

Parts:
C28, C29, C58, C62, C72, C73, C78, C88: 0.1uF; C0402; MPN CL10B104KB8NNND
C57: 22nF; C0402; MPN C1005X7R1E223K050BB
C59, C60, C61: 4.7uF; C0402; MPN GRM155R60J475ME47D
C83: 100uF; RHS1V10MCN1GS; MPN RHS1V101MCN1GS
C93: 10uF; C0805; MPN C2012X5R1V106M085AC
IC7, IC12, IC17: 74AHC1G126DCK; SC70-5; MPN M74VHC1GT126DF1G
IC22: TMC2100-LA; QFN36-PAD; MPN TMC2100-LA-T
J500: 22-05-7048-04; 7395-04; MPN 640455-4
R43: 2.2R; R0402; MPN RC1005J2R2CS
R44, R45: 10K; R0402; MPN RC0402FR-0710KL
R46: 4.7K; R0402; MPN RC0402JR-074K7L
R56, R57: 0.1R; R0805; MPN RL1220S-R10-F
U10: SN74AHC595PW; SOP65P640X120-16N; MPN MC74HC595ADTR2G

Connections:
+3V3: C28.1, C29.1, C62.1, IC7.5 (VCC), IC12.5 (VCC), IC17.5 (VCC), IC22.8 (VCC_IO), R46.2, U10.10 (~SRCLR), U10.16 (VCC); also elsewhere on the board
DIR_H: IC22.7 (REFR_DIR); also elsewhere on the board
ENABLE_H: IC7.4 (O), IC22.22 (DRV_ENN_CFG6)
EN_EH: IC7.2 (I); also elsewhere on the board
FAULT_H: IC22.20 (SWN_DIAG0), R46.1; also elsewhere on the board
GND: C28.2, C29.2, C58.2, C59.1, C60.2, C61.2, C62.2, C73.1, C78.2, C83.-, C88.2, C93.2, IC7.3 (GND), IC12.3 (GND), IC17.3 (GND), IC22.1 (CLK), IC22.10 (SPI_MODE), IC22.11 (GND), IC22.12 (GND), IC22.24 (GNDA), IC22.35 (GND), IC22.36 (TST_MODE), IC22.TP (GND), R56.1, R57.1, U10.8 (GND), U10.13 (~OE); also elsewhere on the board
IREF_H_RAW: R45.2; also elsewhere on the board
IREF_Z10: C61.1, R44.2, R45.1
unnamed: C57.2, IC22.27 (CPO)
unnamed: IC22.14 (BRB), R57.2
unnamed: IC22.33 (BRA), R56.2
unnamed: C60.1, IC22.23 (AIN_IREF), R44.1
unnamed: C57.1, IC22.28 (CPI)
unnamed: IC17.4 (O), IC22.3 (SCK_CFG2)
unnamed: IC22.15 (OB2), J500.4
unnamed: IC22.34 (OA1), J500.2
unnamed: C59.2, IC22.25 (5VOUT), R43.1
unnamed: C72.1, IC22.29 (VCP)
unnamed: IC12.4 (O), IC22.4 (SDI_NAI_CFG1)
unnamed: IC22.5 (SDO_NAO_CFG0), U10.3 (QD)
unnamed: IC22.18 (ENCB_DCEN_CFG4), U10.2 (QC)
unnamed: IC22.19 (ENCA_DCIN_CFG5), U10.1 (QB)
unnamed: IC12.1 (OE), U10.7 (QH)
unnamed: IC12.2 (I), U10.6 (QG)
unnamed: IC17.2 (I), U10.4 (QE)
unnamed: IC17.1 (OE), U10.5 (QF)
unnamed: C58.1, IC22.26 (VCC), R43.2
unnamed: IC22.32 (OA2), J500.1
unnamed: IC22.13 (OB1), J500.3
SER_5: U10.14 (SER); also elsewhere on the board
SPI1_CS1: U10.12 (RCLK); also elsewhere on the board
SPI1_SCLK: U10.11 (SRCLK); also elsewhere on the board
STEP_H: IC22.6 (REFL_STEP); also elsewhere on the board
TRISTATE_STEPPERS: IC7.1 (OE), U10.15 (QA); also elsewhere on the board
VDD_IN: C72.2, C73.2, C78.1, C83.+, C88.1, C93.1, IC22.16 (VS), IC22.30 (VSA), IC22.31 (VS); also elsewhere on the board
