MatthiasPopp/replicape/PCB_rev_B4/Replicape_B4.brd

## EAGLE design PCB_rev_B4/Replicape_B4.brd (continued)

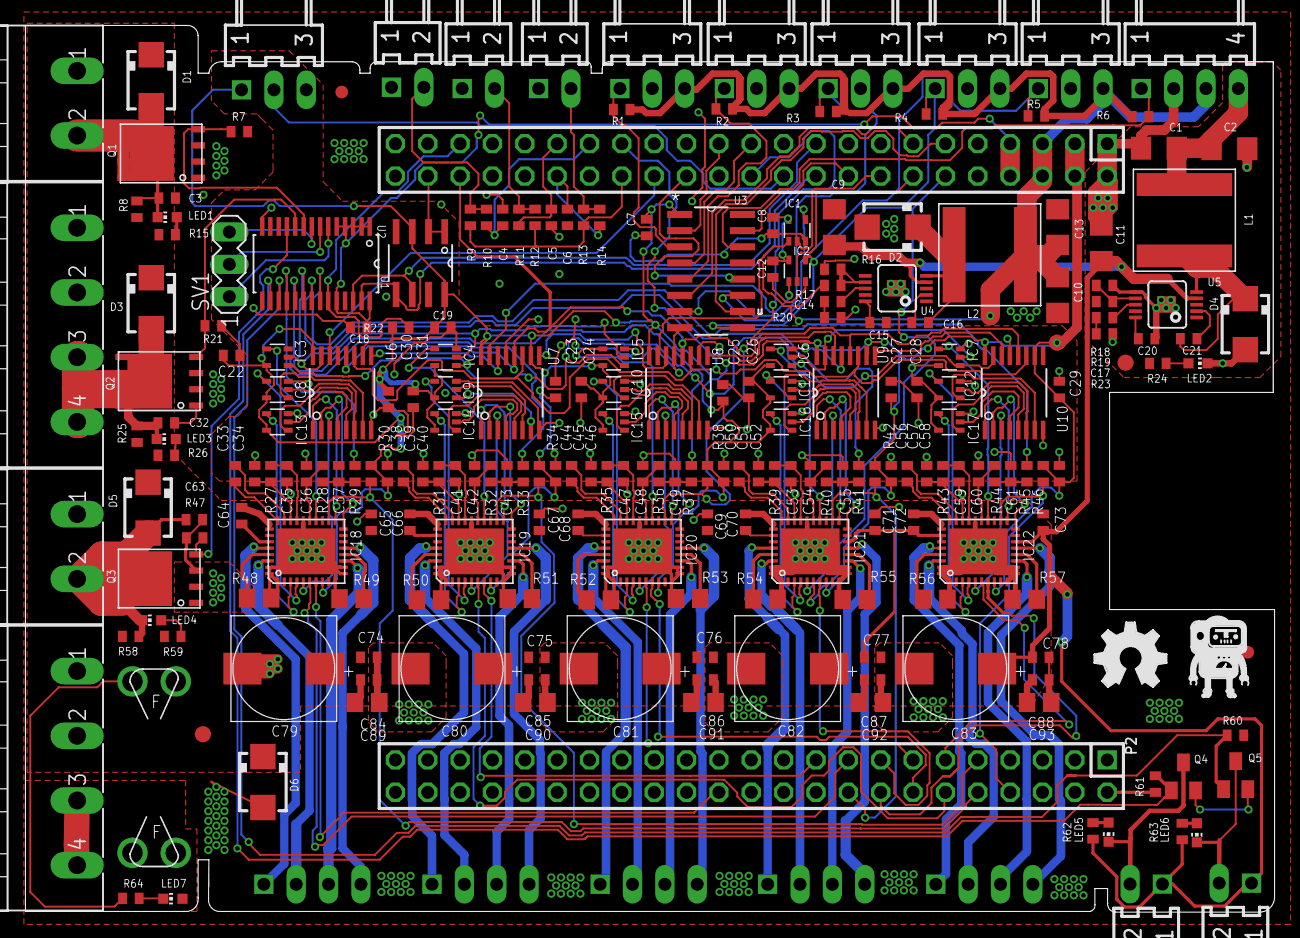
[picture p8: board Replicape_B4.brd from above]

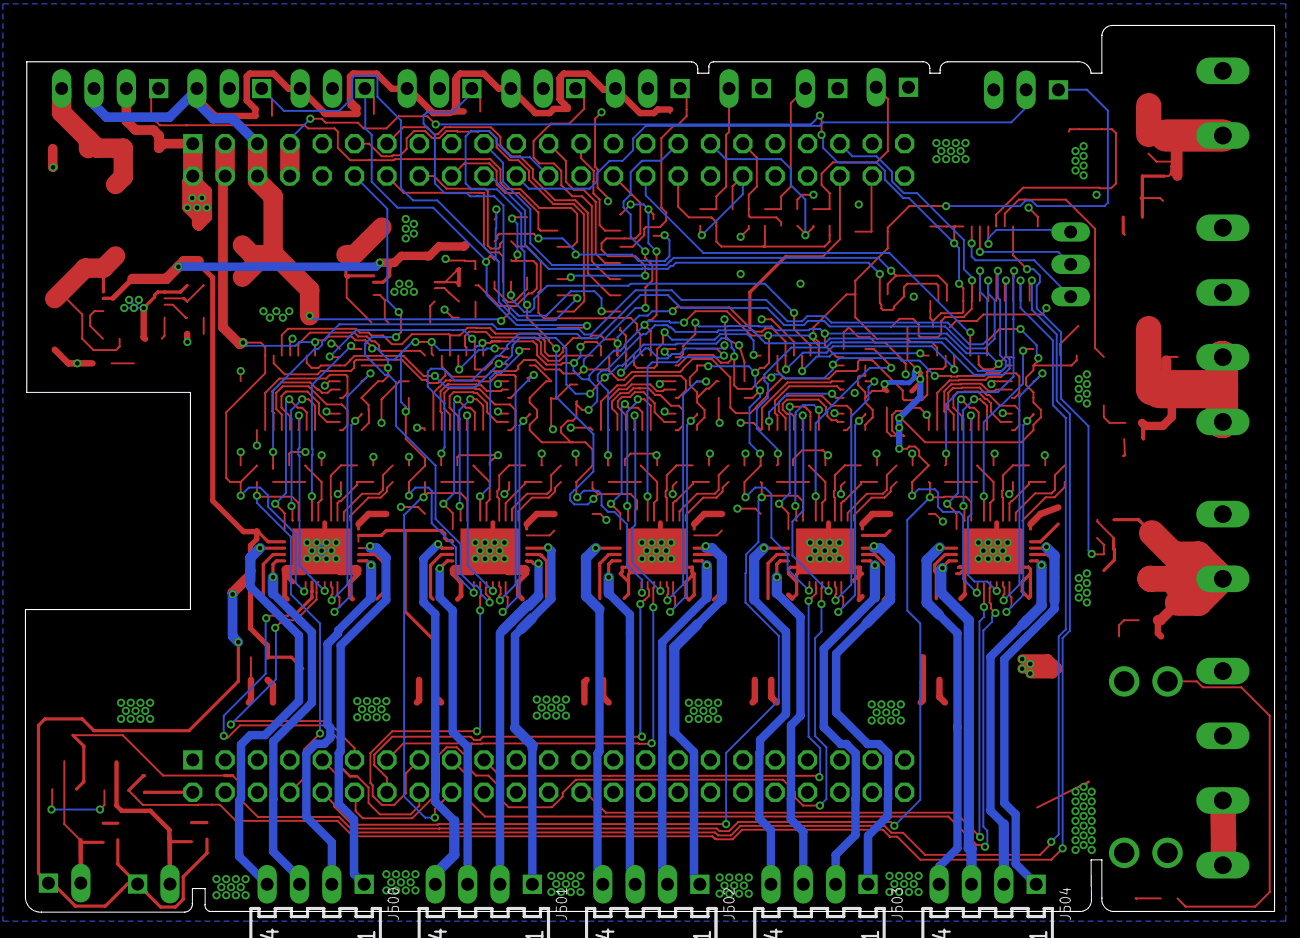
[picture p9: board Replicape_B4.brd from below]

Board: 2 copper layers, 98.1 x 69.6 mm, 249 parts (5 on the bottom side), 211 nets.

Other parts of the board:
U$2: LOGO_BIG
