MatthiasPopp/replicape/(notices)

Notices in the files:
parts and their libraries:
con-headers-jp: Copyright (C) 2008, Bob Starr
